slavikb/BaiMon/EBus-adapter.pdf

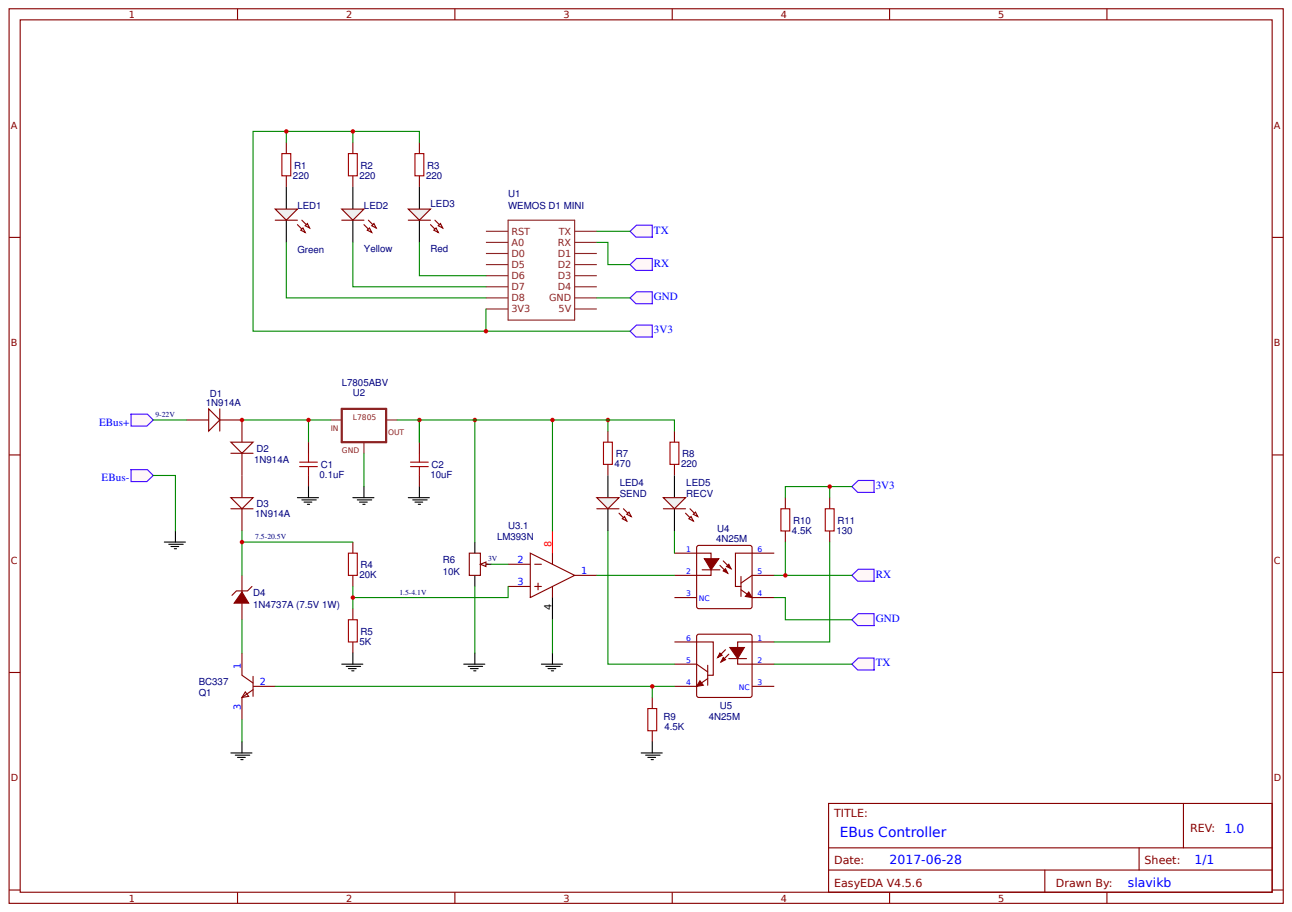
[picture p1: page 1]
