slavikb/BaiMon/(threads)

Thread 1 (2017-09-08):

power from eBus

danielkucera, 2017-09-08:
Hi,

is there any reason why don't you power ESP from eBus?

slavikb, 2017-09-08:
Just for safety. I was not sure that my boiler can provide enough current and was afraid to damage it.

danielkucera, 2017-09-08:
I am thinking about powering my unit from the bus. This would also mean that I don't need to use optocoupling. In theory this should be possible, eBus should provide 50-100mA@20V which means 300-600mA@3V3 according to this: http://ebus-wiki.org/lib/exe/fetch.php/ebus/spec_prot_12_v1_3_1_e.pdf

Do you think it will work?

slavikb, 2017-09-08:
I am not a great specialist in electronics, so i may just guess.
Looks workable, given that ESP8266 drains max 170mA during transmit.
In this case you will need 3V voltage stabilizer, of course.

EUA, 2019-03-05:
FYI: I tried to power my ESP8266 with EBUS 5v.
**I got boiler resets at ignition time**.
Than add step-down regulator ($1-2 USD ones sold at AliExpress, stamp size).
That drop +5V bus to 3.3v, efficiently.
Looks like my boiler working without issue on this setup.
But if you decide to use such a step-down regulator you better to use pin 6(?) which has +24v.
I can't use it since I have no 6p6c RJ11 but 4p4c one.

danielkucera, 2019-03-05:
@EUA , thanks for hints. I'm running it with a stepdown regulator for about a year now a had no troubles so far. Not sure what connector are you talking about but my eBus provides about 20V when idle.

LordMike, 2020-02-10:
@EUA do you have a wiring schematic for powering a 3V3 ESP8266 from the eBUS line?

slavikb, 2020-02-10:
Unfortunately, not. AFAIK, danielkucera had developed such device.

LordMike, 2020-02-10:
Tagging @danielkucera to hear if he has a schematic. :)

danielkucera, 2020-02-10:
@LordMike This is what I use: https://github.com/danielkucera/ebus-adapter

It works but the DC/DC regulator is squeaking and I didn't find out why so far. Maybe it would be worth try to replace the regulator module with a different chip.

LordMike, 2020-02-10:
Could I trouble you to add a few lines to the repo, which file is what etc.. ?

I'm not familiar with a few of the filetypes, and it seems like there's a mix of a v1 and v2 ?

danielkucera, 2020-02-10:
It's still quite raw repo. Just use KiCAD and open `wiring.pro`

EUA, 2020-02-10:
@LordMike , nope. I don't have schematics. Just make it on breadboard.

Closed 2019-03-05.

Thread 2 (2018-11-03):

temp control

serjepatoff, 2018-11-03:
Not actually an issue, but a question.

Is it possible to control temperature of Vaillant boiler (in other words, to create my own DIY thermostat) using your hardware/software?

slavikb, 2018-11-04:
Hello,
This is possible, hardware do not need any change, but software must be modified - should include control logic and use 'write parameter' commands (I used only 'read parameter').
You may learn about Vaillant command codes from OpenHAB v1 sources (https://github.com/openhab/openhab1-addons/blob/master/bundles/binding/org.openhab.binding.ebus/src/main/resources/vaillant-bai00-configuration.json). Vaillant Turbotec identifies itself as BAI00 (hence the project name 'BaiMon')

rems2235, 2019-08-18:
Hello,
Great working. Thanks for all.

I want to read d.05 and d.41. i tried to change adress. 0x18 to 0x39. but there was error to read. how can i read these parameters. can you help me please. i am an amateur. what changes must be done for these d.05 and d.41. can i add these parameters to program. thank you.

slavikb, 2019-08-20:
Hello,
You need to know parameter format. Different parameters may have different length of response data (parameter 3 for PrepGetParm call). You may try to modify it, e.g. change from 3 to 2 or 4.
Some parameters are documented in OpenHab project docs: https://github.com/openhab/openhab1-addons/blob/1.8/bundles/binding/org.openhab.binding.ebus/src/main/resources/vaillant-bai00-configuration.json.
To add new parameter to BaiMon, you should define static EBusCommand structure and add it to the linked list in the ProcessMonitor() function (see the 'Build EBus command chain' comment). In case of adding large number of commands, COMMAND_TIMEOUT should be increased accordingly.

rems2235, 2019-08-21:
Thank you Slavikb. I will try to change it.

slavikb, 2019-08-22:
rems2235, you can use 'Diagnostics' page on web interface to examine actual data being send on EBus, this may help to analyze what is going wrong.

rems2235, 2019-08-22:
hello slavikb. i was changed the resp lenght 3 to 2. and also parm no 0x18 to 0x39 (d.05). then it works. it reads the d.05 data and upload to narodmon. wonderfull. i am very happy . thanks for all suggestions.
now i will try to add more parameter to lovely Baimon.  i will give the information about this amazing programing experience (or maybe copying the project :)   )

Thank you very much.  see you.

zamdr, 2020-10-11:
Hi. This is a great program! tell us if you are ready to write updates for boiler management, so that you can not only read but also set parameters. I'm willing to pay upgrade fees.

slavikb, 2020-10-12:
> Hi. This is a great program! tell us if you are ready to write updates for boiler management, so that you can not only read but also set parameters. I'm willing to pay upgrade fees.

Thank you!
For now, I do not plan to implement commands to the boiler, for number of reasons:
- there is no documentation for Vaillant e-bus commands and there is a risk to break something while experimenting
- sending such commands remotely present security risks, you must implement some authentication, that is not a simple thing (e.g. you may need a secure MQTT server)

zamdr, 2020-10-12:
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

There is a similar project" eBUSd", where boiler management is implemented. Unfortunately, it is complex and requires the installation of additional libraries and daemons. Your project is very simple and convenient, it has a great potential. I think that in order not to break the system, you can limit yourself to just a few commands: "turn on / off the heating", "set the temperature", "read the temperature of the external sensor". Once again, I am ready to pay for this work. For direct communication with me, you can find me in the telegram @zam_dr.

slavikb, 2020-10-12:
zamdr, thanks for the proposal, but for now, I just have no spare time to work fully on such project, even for money.
However I'll look at eBUSd, maybe get some ideas from it)

zamdr, 2020-10-12:
Thank You Vyacheslav. I would be very grateful if you would respond to my suggestion)

Thread 3 (2021-02-13):

Hardware question

bofruehw, 2021-02-13:
It is a very interesting project.
My question is if it is possible to find a suitable eBus to serial 3.3 V converter on eBay or similar. I presume that it would be much smaller than the homemade one made on the prototype board. And probably cheaper.
THX

Thread 5 (2021-03-21):

Controller resets Vaillant VRC630 calorMatic

bofruehw, 2021-03-21:
I have a problem because the controller reset my Vaillant VRC630 calorMatic when I connect it, connect ESP and when I send a telegram.
In an idle situation without ESP connected after the green led in it is on and everything works.

Additionally, I'm not sure how to determine device addresses.

Any suggestions?

THX
Regards

slavikb, 2021-03-21:
Hi,
Looks like VRC630 has different command to read parametrs (and different parameter IDs).
I advise you to examine OpenHab ebus bindings:

For my  TurboTec (identification: BAI00) commands are described here:
https://github.com/openhab/openhab1-addons/blob/main/bundles/binding/org.openhab.binding.ebus/src/main/resources/vaillant-bai00-configuration.json

For VRC630 you should look here:
https://github.com/openhab/openhab1-addons/blob/main/bundles/binding/org.openhab.binding.ebus/src/main/resources/vaillant-vrc630-configuration.json

It seems commands really differ. For example, to read temperature:
BAI00: "<Boiler> Flow temperature D.040 (°C)":    command: "B5 09", data:  "0D 18 00", dst:  "08",
VRC630:  "<Controller> Flow temperature (°C)"  command:  "B5 09", data: "0D 02 00", dst: "15",
Unfortunately I did not found command to read pressure. I have no other sources of information, so cannot help further.

To determine your boiler address you can try to use [Diagnostics] page and monitor raw EBus data to spot periodic broadcasts from boiler. To avoid boiler resets, just comment out code that sends commands to the boiler (function: ProcessMonitor, force needRequest=false).
