slavikb/BaiMon/(commit log)

2017-06-26 EBus adapter schematics added
2017-07-01 Version 1.1, added button to force request
2017-07-08 New adapter schematics
2017-07-08 Added schematic remarks
2017-07-08 Schematics updated
2017-07-21 version 1.2, failed commands diagnostics
    [BaiMon.ino]
2018-09-29 version 1.3 - simplified, removed SPIFFS, sending device state to narodmon
2019-07-13 v1.4 - switched to MQTT protocol
